ThongTran23021922/line-follower-robot/Docs/Circuit.png

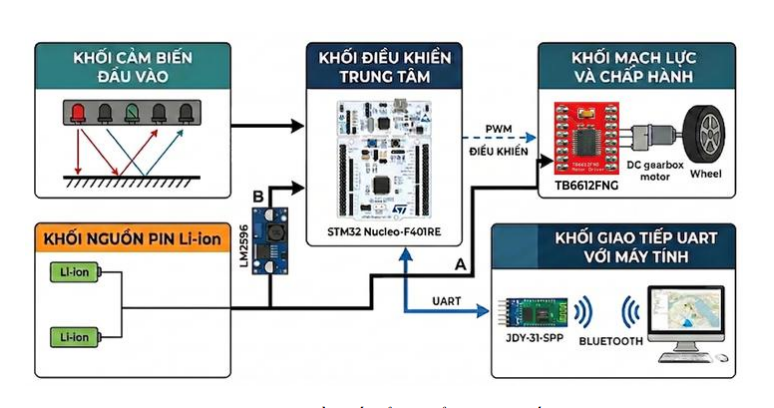
Docs/Circuit.png
