ThongTran23021922/line-follower-robot/Docs/Robot.png

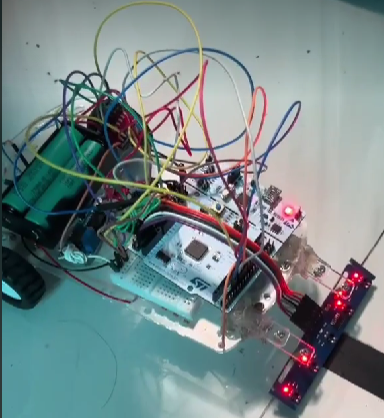
Docs/Robot.png
